mirdej/videobass/maxmsp/building/Building_Instructions.txt

Building instructions

1) Open ../Videobass.maxpat with MaxMSP
2) Make sure you switch to the main patch
2) Build standalone Application into building folder
3) Adapt version.txt
3) Run make in building folder

Move the resulting Videobass disk image to wherever you like
