mirdej/videobass/hardware/plans/Saddle.pdf

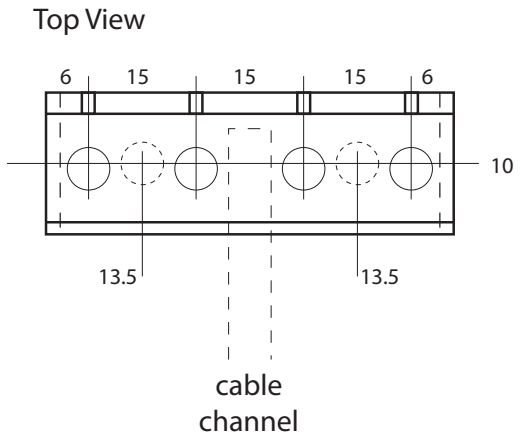
[picture p1: figure]
cable channel; Top View

5

Side View

8

## Videobass Saddle

Cut from hard wood
Michael Egger
2011-05-28
