mirdej/videobass/hardware/plans/Head.pdf

## Videobass Head

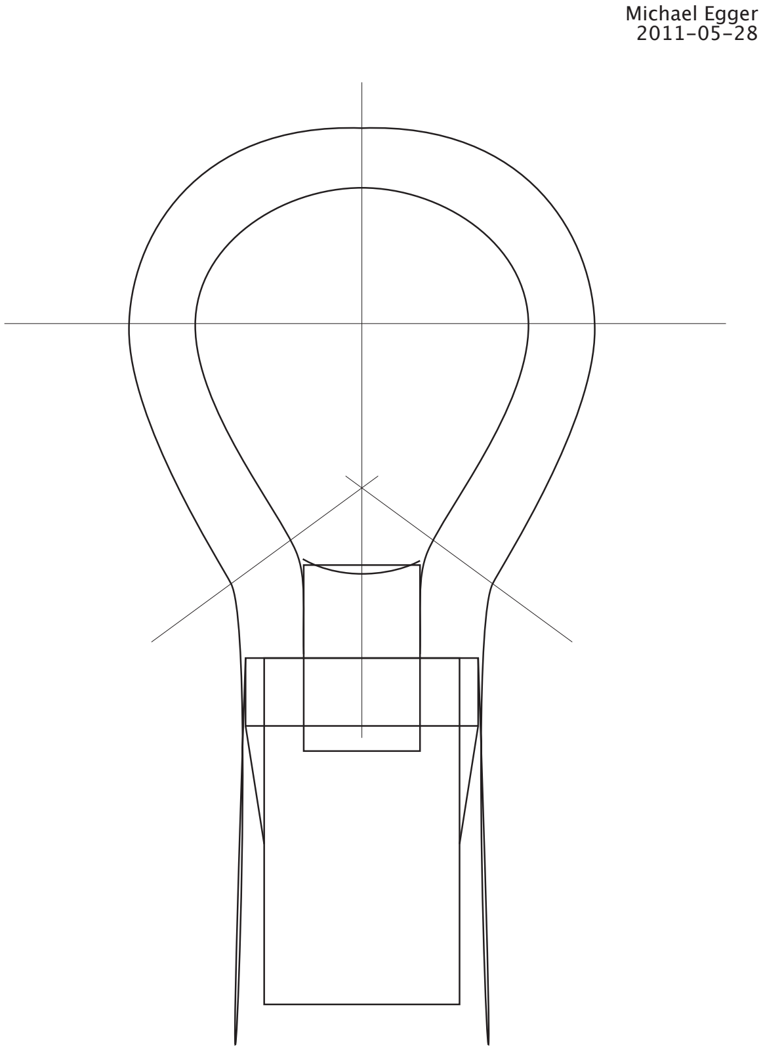
[picture p2: figure]
Michael Egger 2011-05-28
