mirdej/videobass/maxmsp/main/vb.viewer.pict.png

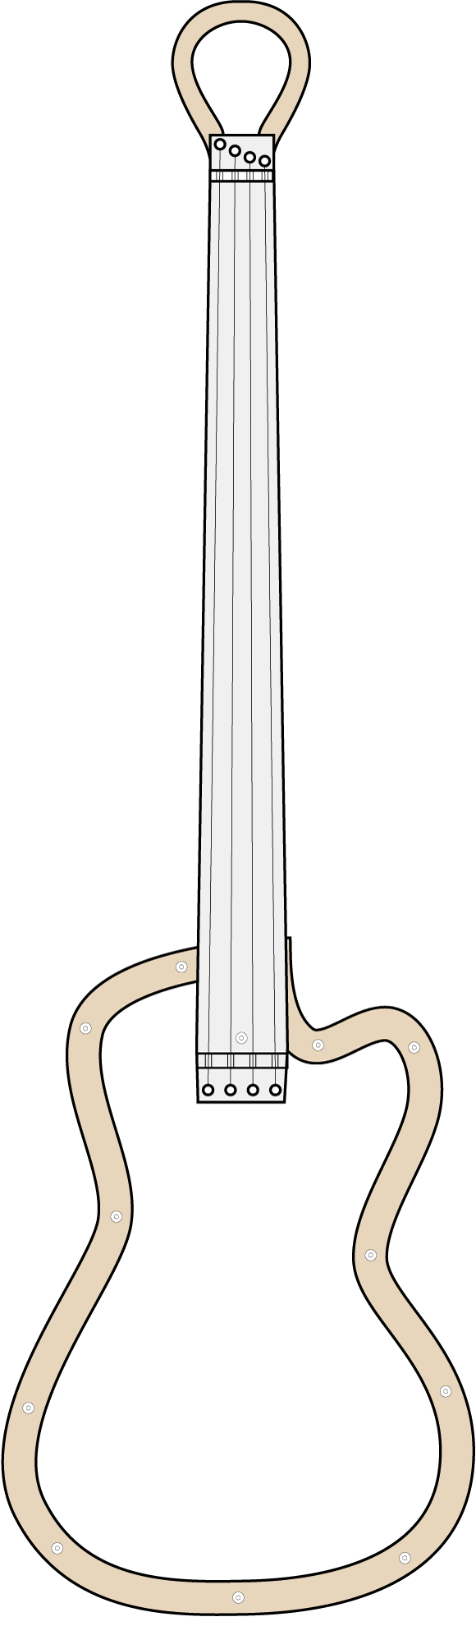
maxmsp/main/vb.viewer.pict.png
