mirdej/videobass/maxmsp/txt/hi.ExtendedUsages.txt

# extended usages - one symbol matches a usage page / usage pair.
#
# File format:
# <symbol> <usage-page> <usage>
# anything after a '#' will be ignored

mouse		1	0x02
gamepad		1	0x05
keyboard	1	0x06
xaxis		1	0x30
yaxis		1	0x31
slider		1	0x36
dial		1	0x37
wheel		1	0x38
