mirdej/videobass/maxmsp/txt/hi.UsagePages.txt

# extended usages - one symbol matches a usage page.
#
# File format:
# <symbol> <usage-page>
# anything after a '#' will be ignored

gendesk		 1
simcontrol	 2
vrcontrol	 3
sport		 4
game		 5
generic		 6
keyboard	 7
leds		 8
buttons		 9
ordinal		10
telephone	11
consumer	12
digitizers	13
unicode		16
alphanum	20
medical		64
