mirdej/videobass/maxmsp/building/ReadMe.rtf

Videobass 3.3.8.1 ReadMe

The Videobass is a unique hardware software combination -
an instrument that plays moving images instead of sound.

It is an open source project by Swiss media artist Michael Egger.
For more Information visit http://www.anyma.ch/research/videobass.

This is the Readme for the Videobass-Application.
In itself the Application is useless without the Videobass hardware controller (and, less so, the videobass "amplifier" hardware). Plans for building the necessary hardware can be found on the above website, on the SVN repository at http://code.google.com/p/videobass/ or by contacting the author by email: me-AT-anyma.ch

The application is written in MaxMSP/jitter - its source code is published under GNU GPL 3.0 or greater, please refer to the above SVN repository for latest sources.

Installation

Drag the Videobass Application into the Applications folder.
It will generate all necessary settings and folders on startup. These are:

~/Library/Preferences/Videobass/ for settings and preferences
~/Videobass Clips/ clips to be played by the videobass
~/Videobass Recordings/ recordings made by the videobass
~/Videobass Scales/ text files defining sets of clips

Changes in version 3.3.8.1
- fixed bug when changing scales would not remove clips from last scale

Changes in version 3.3.8
- added "scrubbing" or "tapping" mode. double-click the fold button to enter scrubbing mode

Changes in version 3.3.7
- added possibility to change the range of the speed control in the settings

Changes in version 3.3.6.1
- fixed build (3.3.6 does not work at all)

Changes in version 3.3.6
- reenabled luma key on the E string

Changes in version 3.3.5
- more reliable string calibration
- there's a beep when string in/out points are set

Changes in version 3.3.4
- buffer pedal only calibrates itself when we're actually calibrating
- disabled luma key on the E string to prevent accidental blackouts

Changes in version 3.3.3
- fixed a bug where live recording would reset the videobass
- fixed: recording names now properly display seconds
- disabled scale-change footpedal when no or just one scale present

Changes in version 3.3.2
- fixed fullscreen mode, leaving fullscreen will make a small window
- fixed 'unbound hi.in' error in vb.input
- cleaned up settings display
- fixed possible bug with NTSC recording
- strip path off clipnames when loading clips

Changes in version 3.3.1
- Interface adapts to any screen size: this version works also on a laptop
- Fixed bug where buffer detoriates over time
- Playback frame size can now be set in the settings panel

Changes in version 3.2.1

- added possibility to prepare scales: text files that define what clips are in which order on a string.
one can change from scale to scale quickly with the foot pedal

- fixed bug where unfolded clips would remain when reloading media.
- fixed string initialisation when changing scales

Changes in version 3.1.1

- textures sent over network are again in uyvy format for compatibilty with VideobassSyphonServer
- added settings for recording fps and size

Changes in version 3.1.0

- individual channels can now have luma key transparency. This changes somewhat the mixing behavior. For a description, see http://code.google.com/p/videobass/wiki/Mixing
- channel displays update more frequently

Bugfixes:
- fixed copying joystick settings from 4 to 1 and from 1 to 4
- movie transport mechanism now uses internal quicktime clock, this should render playback speed more reliable
- fixed bug where thumbnail of first clip would not show
- fixed bug where a recording slot was added even when no slots are requested
- live recording should now record at correct framerate
- clearing recordings works now even when there are spaces in hard disk name

Known Issues

- Playback is not optimized yet: frame rate is below optimal (usually between 16 and 20 fps)
- Playback is only extensively tested for clips in DV-PAL format (720x576 25fps 4:3)
- Playback is 4:3 only
