mirdej/videobass/syphon_server/building/Building_Instructions.txt

Building instructions

1) Open ../VideobassSyphonServer.maxpat with MaxMSP
2) Build standalone Application into building folder
3) Adapt version number in Makefile !!!
3) Run make in building folder

Move the resulting Videobass disk image to wherever youlike
