mirdej/videobass/maxmsp/building/vb.install.png

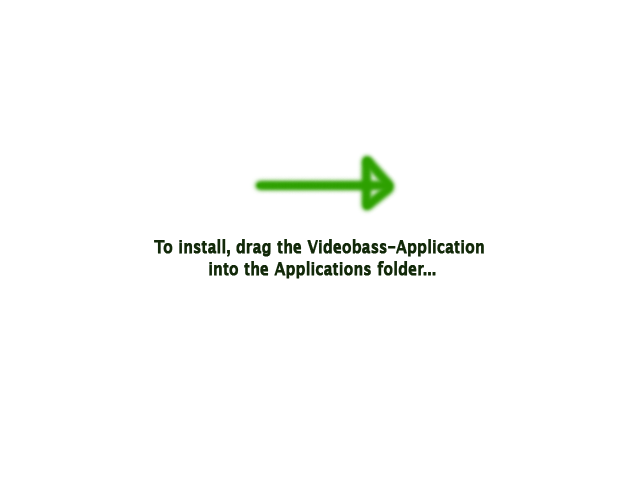
maxmsp/building/vb.install.png
