mirdej/videobass/hardware/electronics/pots_pcb.pdf

## Videobass Pot Board

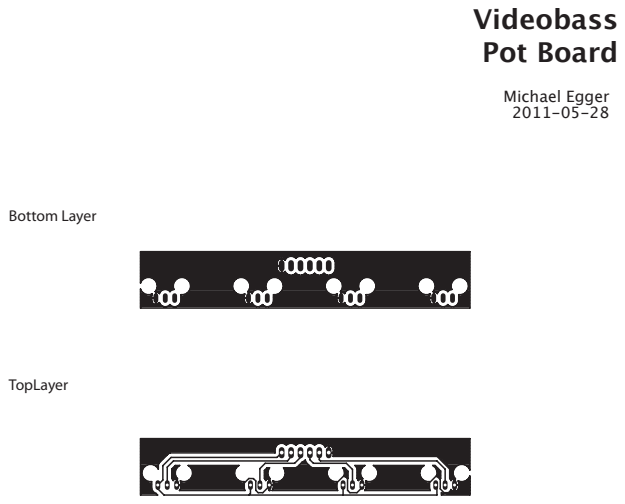
[picture p5: page 1]
Bottom Layer; TopLayer; Michael Egger 2011-05-28
