mirdej/videobass/hardware/electronics/amp-pcb.pdf

## Videobass Amplifier Board

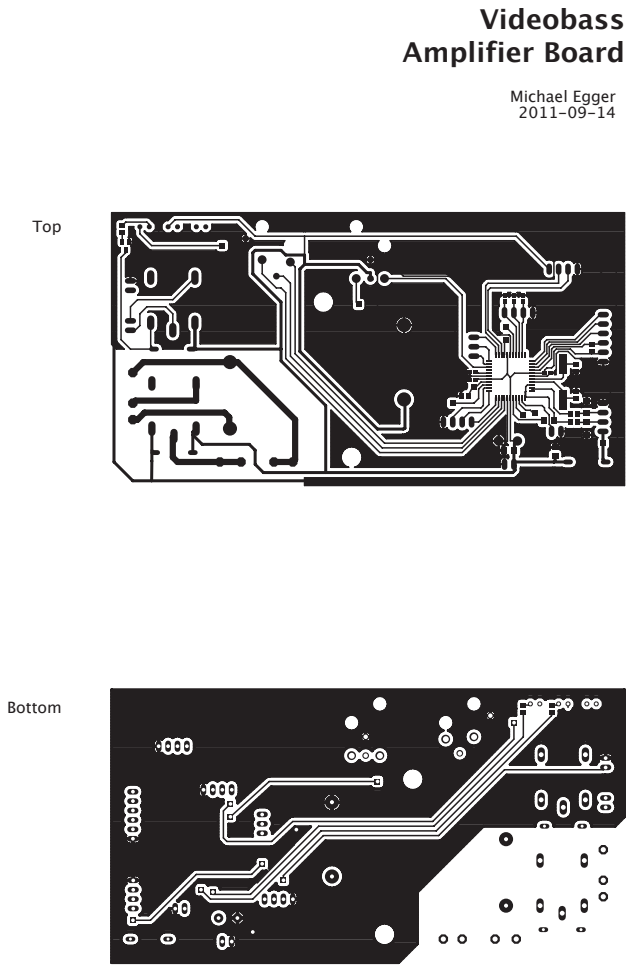
[picture p6: page 1]
Michael Egger 2011-09-14; Top; Bottom
