mirdej/videobass/hardware/electronics/cpu_pcb.pdf

## Bottom Layer

# Videobass

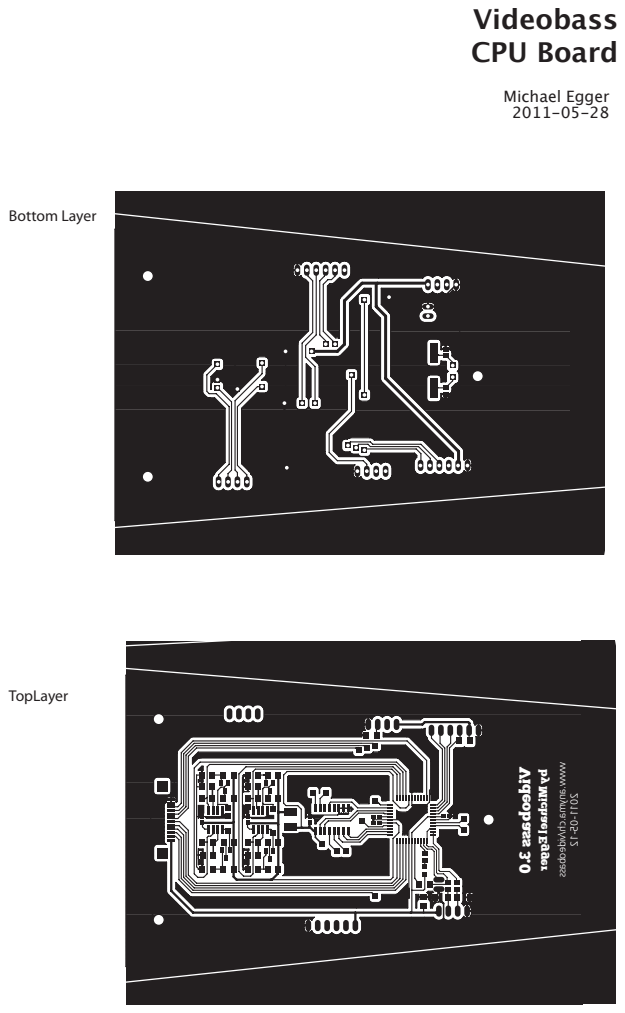
[picture p7: page 1]
Videobass 3.0; TopLayer; CPU Board; Michael Egger 2011-05-28

by Michael Egger

www.anyma.ch/videobass
