mirdej/videobass/hardware/electronics/joystick-pcb.pdf

## Videobass Joystick Board

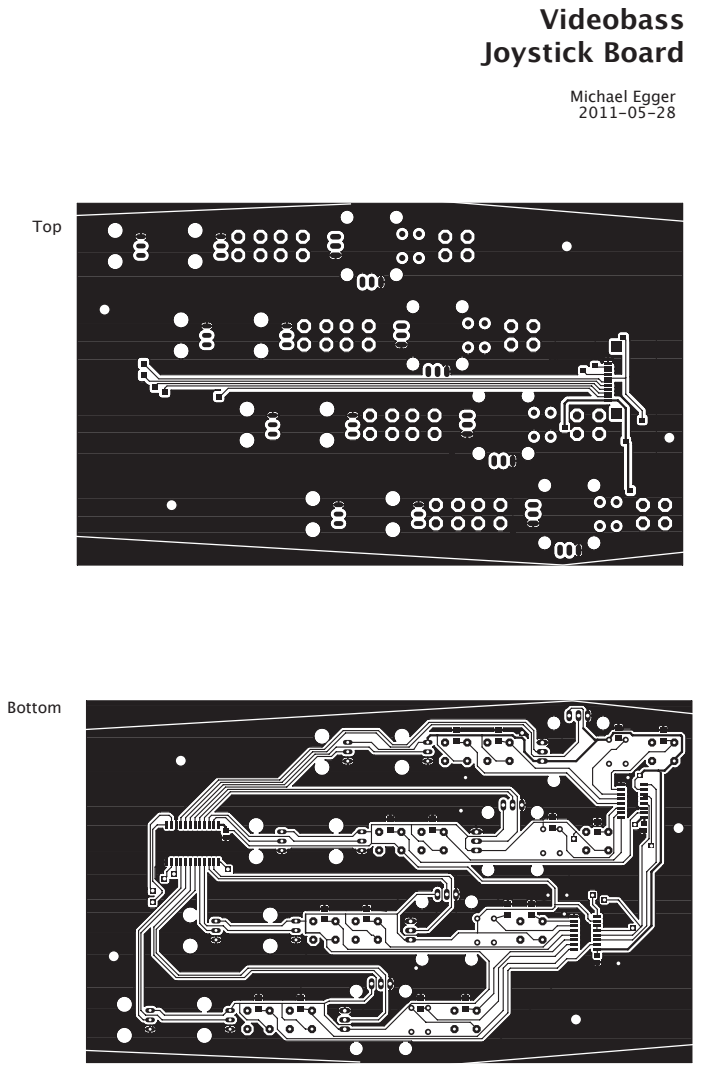
[picture p8: page 1]
Michael Egger 2011-05-28; Top; Bottom
