mirdej/videobass/hardware/plans/Body-Jig.pdf

## Videobass Body Jig

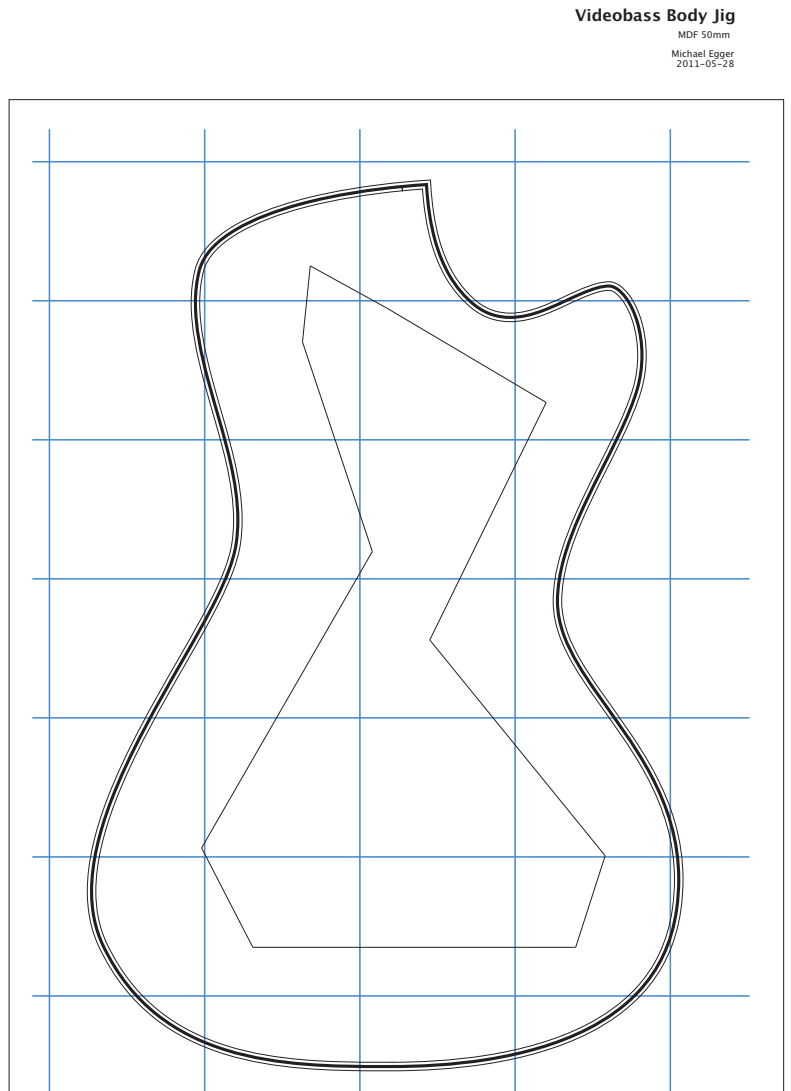
[picture p9: page 1]
MDF 50mm Michael Egger 2011-05-28
