mirdej/videobass/hardware/plans/Plexi_Drill_Template.pdf

# Videobass Plexi Drill Template

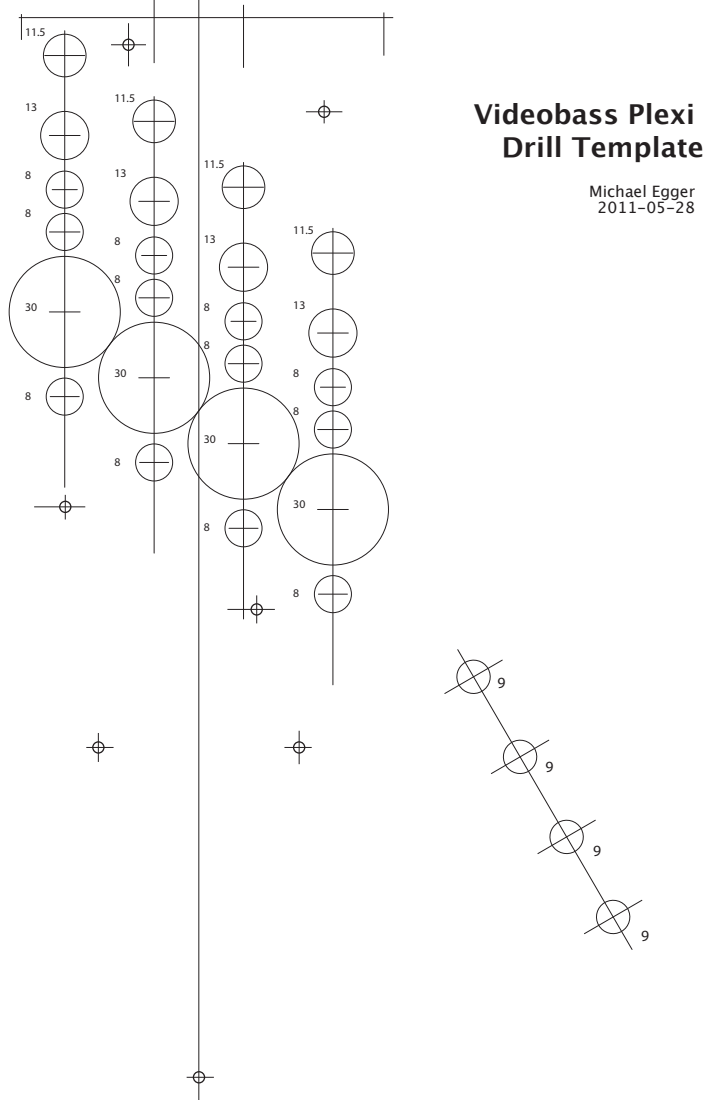
[picture p10: page 1]
Michael Egger 2011-05-28
