mirdej/videobass/hardware/plans/Stand.pdf

## Videobass Stand Cutting Template

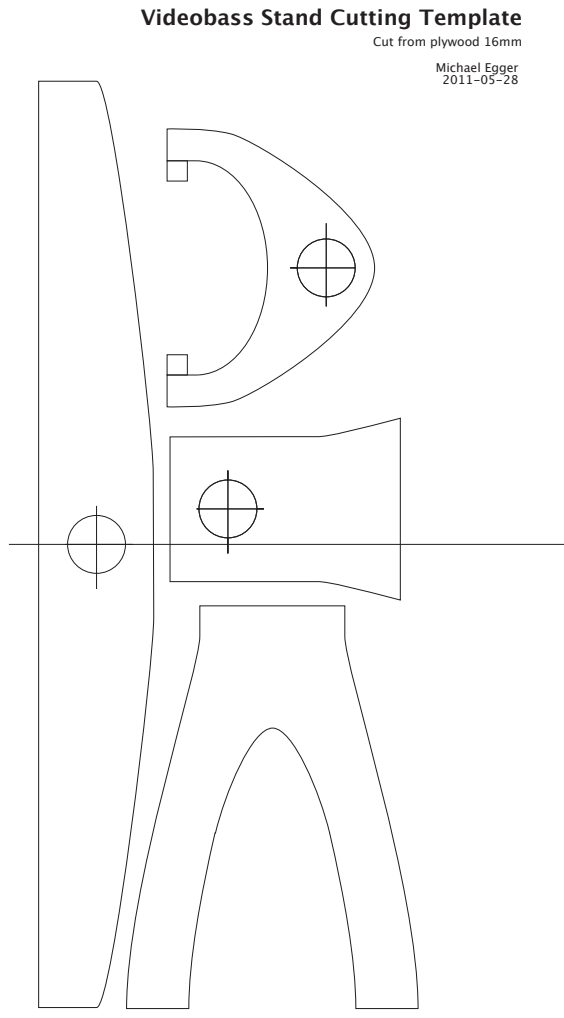
[picture p11: page 1]

Cut from plywood 16mm
Michael Egger
