mirdej/videobass/hardware/plans/Videobass.pdf

## Videobass Version 3.0

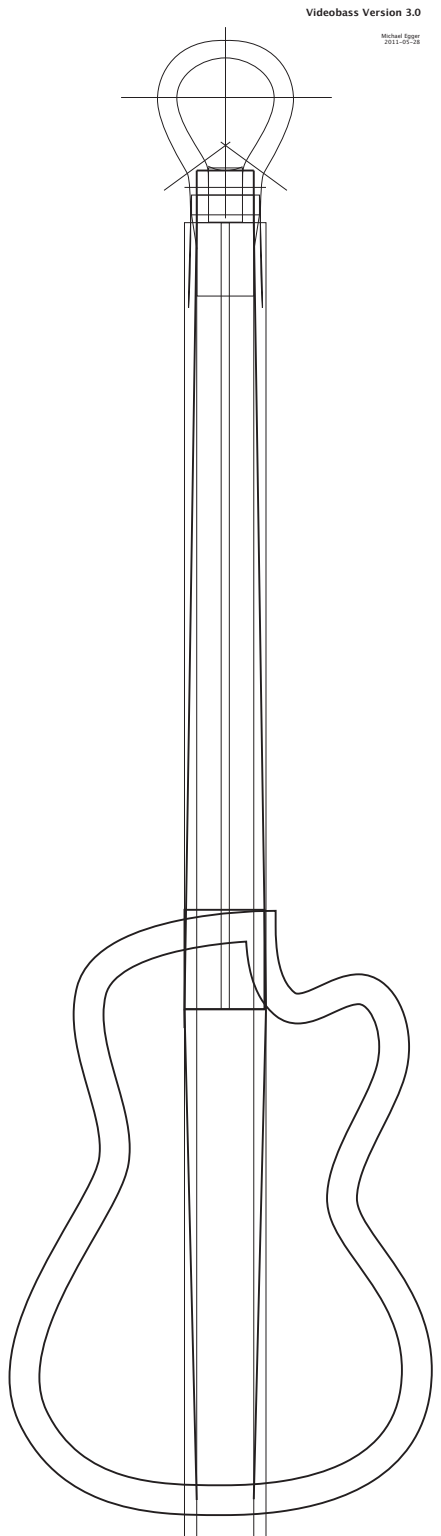
[picture p12: page 1]
Michael Egger 2011-05-28
