mirdej/videobass/hardware/electronics/cpu.brd

## EAGLE design hardware/electronics/cpu.brd (2012-11-18)

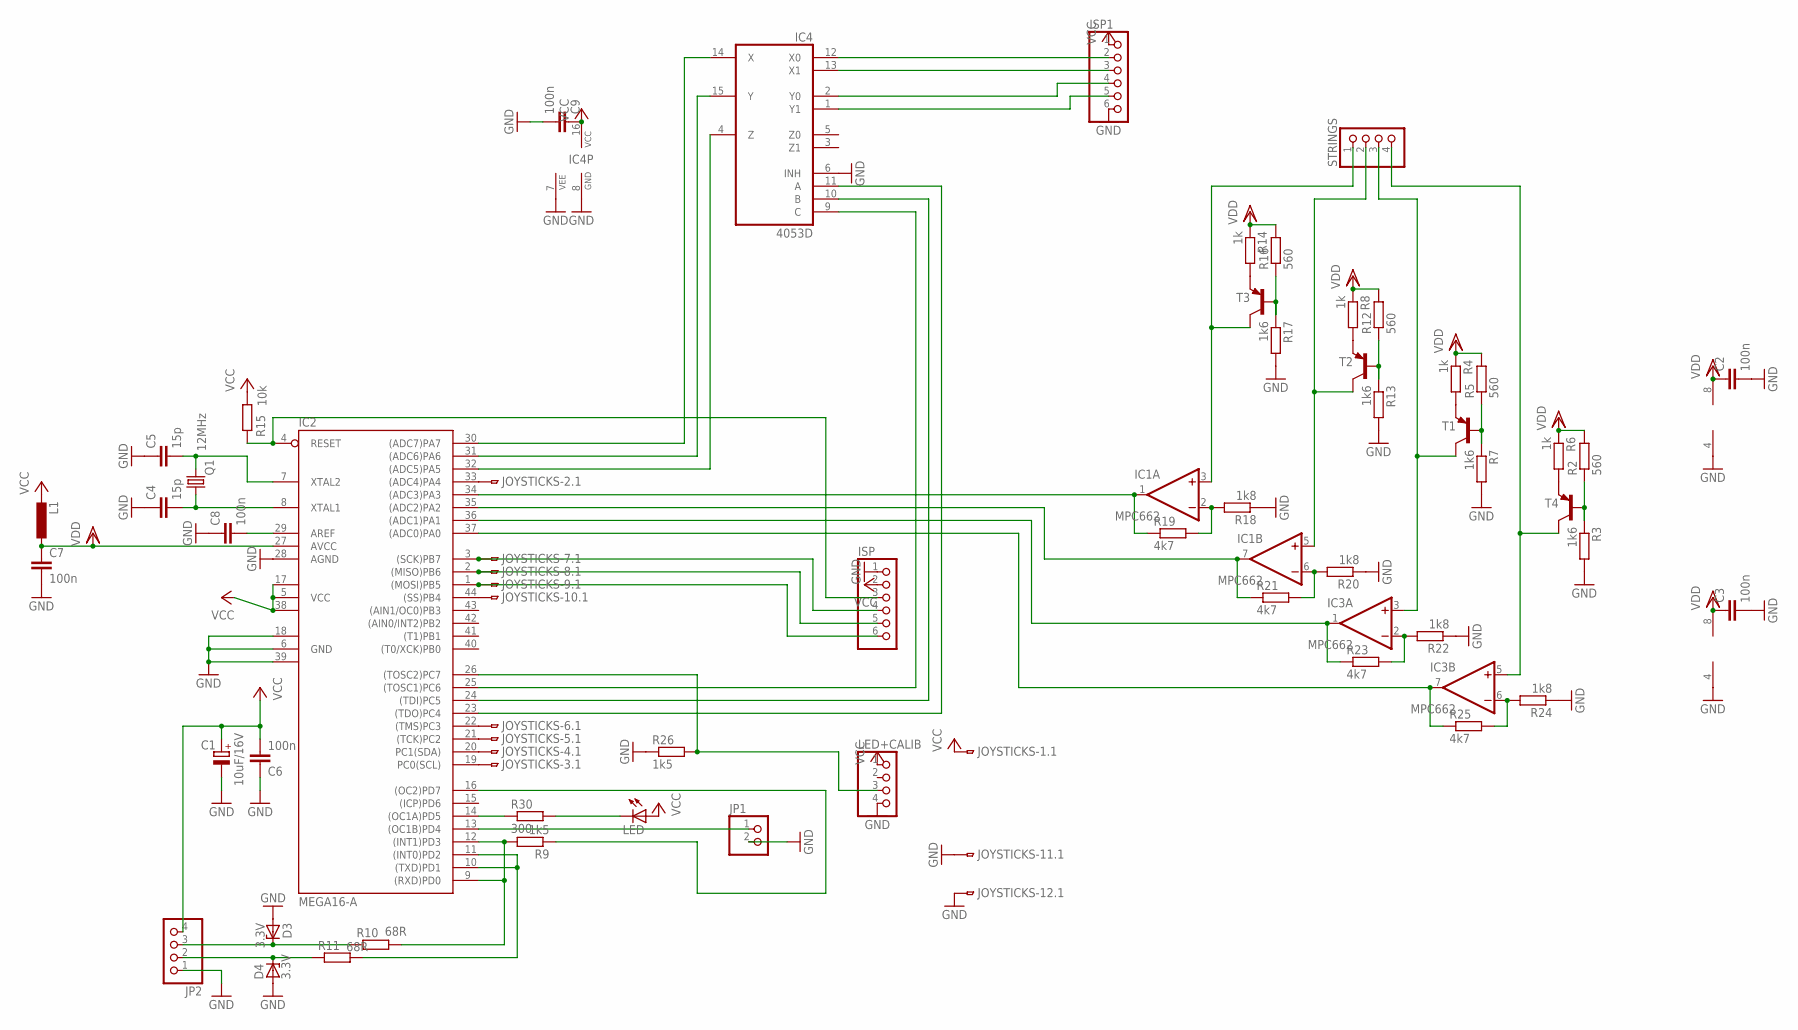
[picture p13: schematic cpu.sch]

Parts:
C1: 10uF/16V; R/2012-12R
C2, C3, C6, C7, C8, C9: 100n; C0603
C4, C5: 15p; C0805
D3, D4: 3.3V; SOD80C
IC1, IC3: MPC662; SO08
IC2: MEGA16-A; TQFP44
IC4: 4053D; SO16
ISP, ISP1: PINHD-1X6; 1X06
JOYSTICKS: MOLEX-52207-1285; 52207-1285
JP1: PINHD-1X2; 1X02
JP2: PINHD-1X4; 1X04
L1: L-EUL1812; L1812
LED: LEDCHIPLED_0805; CHIPLED_0805
LED+CALIB: PINHD-1X4; 1X04
Q1: 12MHz; HC49UP
R2, R5, R12, R16: 560; R1206
R3, R7, R13, R17: 1k6; R1206
R4, R6, R8, R14: 1k; R1206
R9, R26: 1k5; R1206
R10, R11: 68R; M0805
R15: 10k; R1206
R18, R20, R22, R24: 1k8; R1206
R19, R21, R23, R25: 4k7; R1206
R30: 300; M0805
STRINGS: PINHD-1X4; 1X04
T1, T2, T3, T4: -PNP-SOT23-BCE; SOT23-BCE

Connections:
D+: D4.C, JP2.2, R11.1
D-: D3.C, JP2.3, R10.1
GND: C1.-, C2.2, C3.2, C4.1, C5.1, C6.1, C7.2, C8.1, C9.2, D3.A, D4.A, IC1.4 (V-), IC2.6 (GND), IC2.18 (GND1), IC2.28 (AGND), IC2.39 (GND2), IC3.4 (V-), IC4.6 (INH), IC4.7 (VEE), IC4.8 (GND), ISP.1, ISP1.6, JOYSTICKS.P$11, JOYSTICKS.P$12, JP1.2, JP2.1, LED+CALIB.4, R3.2, R7.2, R13.2, R17.2, R18.1, R20.1, R22.1, R24.1, R26.1
unnamed: IC2.9 ((RXD)PD0), IC2.12 ((INT1)PD3), R9.2, R10.2
unnamed: IC1.1 (OUT), IC2.34 ((ADC3)PA3), R19.1
unnamed: IC1.2 (-IN), R18.2, R19.2
unnamed: IC2.1 ((MOSI)PB5), ISP.6, JOYSTICKS.P$9
unnamed: IC1.6 (-IN), R20.2, R21.2
unnamed: C4.2, IC2.8 (XTAL1), Q1.1
unnamed: IC4.13 (X1), ISP1.3
unnamed: IC2.14 ((OC1A)PD5), R30.1
unnamed: IC4.12 (X0), ISP1.2
unnamed: IC2.13 ((OC1B)PD4), JP1.1
unnamed: C8.2, IC2.29 (AREF)
unnamed: R6.2, T4.E
unnamed: IC2.16 ((OC2)PD7), R9.1
unnamed: LED.C, R30.2
unnamed: IC3.5 (+IN), STRINGS.4, T4.C
unnamed: R2.1, R3.1, T4.B
unnamed: R4.2, T1.E
unnamed: IC3.3 (+IN), STRINGS.3, T1.C
unnamed: R5.1, R7.1, T1.B
unnamed: R8.2, T2.E
unnamed: IC1.5 (+IN), STRINGS.2, T2.C
unnamed: R12.1, R13.1, T2.B
unnamed: R14.2, T3.E
unnamed: IC1.3 (+IN), STRINGS.1, T3.C
unnamed: R16.1, R17.1, T3.B
unnamed: IC1.7 (OUT), IC2.35 ((ADC2)PA2), R21.1
unnamed: IC2.10 ((TXD)PD1), IC2.11 ((INT0)PD2), R11.2
unnamed: IC3.2 (-IN), R22.2, R23.2
unnamed: IC2.36 ((ADC1)PA1), IC3.1 (OUT), R23.1
unnamed: IC3.6 (-IN), R24.2, R25.2
unnamed: IC2.37 ((ADC0)PA0), IC3.7 (OUT), R25.1
unnamed: IC2.2 ((MISO)PB6), ISP.5, JOYSTICKS.P$8
unnamed: IC2.3 ((SCK)PB7), ISP.4, JOYSTICKS.P$7
unnamed: IC2.33 ((ADC4)PA4), JOYSTICKS.P$2
unnamed: IC2.19 (PC0(SCL)), JOYSTICKS.P$3
unnamed: IC2.20 (PC1(SDA)), JOYSTICKS.P$4
unnamed: IC2.21 ((TCK)PC2), JOYSTICKS.P$5
unnamed: C5.2, IC2.7 (XTAL2), Q1.2
unnamed: IC2.22 ((TMS)PC3), JOYSTICKS.P$6
unnamed: IC2.44 ((SS)PB4), JOYSTICKS.P$10
unnamed: IC2.32 ((ADC5)PA5), IC4.4 (Z)
unnamed: IC2.31 ((ADC6)PA6), IC4.15 (Y)
unnamed: IC2.30 ((ADC7)PA7), IC4.14 (X)
unnamed: IC2.23 ((TDO)PC4), IC4.11 (A)
unnamed: IC2.24 ((TDI)PC5), IC4.10 (B)
unnamed: IC2.25 ((TOSC1)PC6), IC4.9 (C)
unnamed: IC4.2 (Y0), ISP1.4
unnamed: IC4.1 (Y1), ISP1.5
unnamed: IC2.26 ((TOSC2)PC7), LED+CALIB.3, R26.2
unnamed: IC2.4 (RESET), ISP.3, R15.1
VCC: C1.+, C6.2, C9.1, IC2.5 (VCC), IC2.17 (VCC1), IC2.38 (VCC2), IC4.16 (VCC), ISP.2, ISP1.1, JOYSTICKS.P$1, JP2.4, L1.2, LED.A, LED+CALIB.1, R15.2
VDD: C2.1, C3.1, C7.1, IC1.8 (V+), IC2.27 (AVCC), IC3.8 (V+), L1.1, R2.2, R4.1, R5.2, R6.1, R8.1, R12.2, R14.1, R16.2

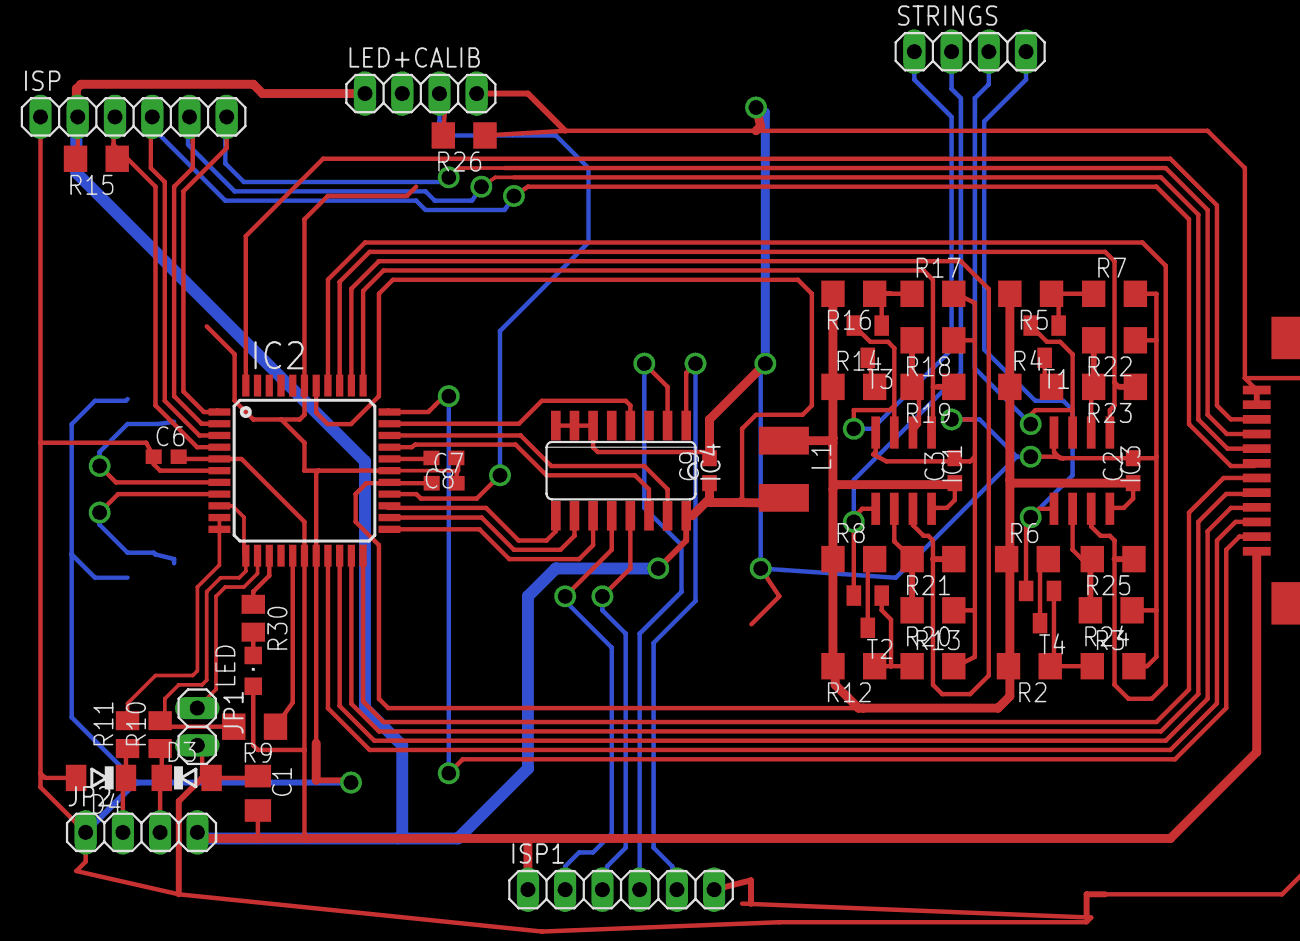
[picture p14: board cpu.brd from above]

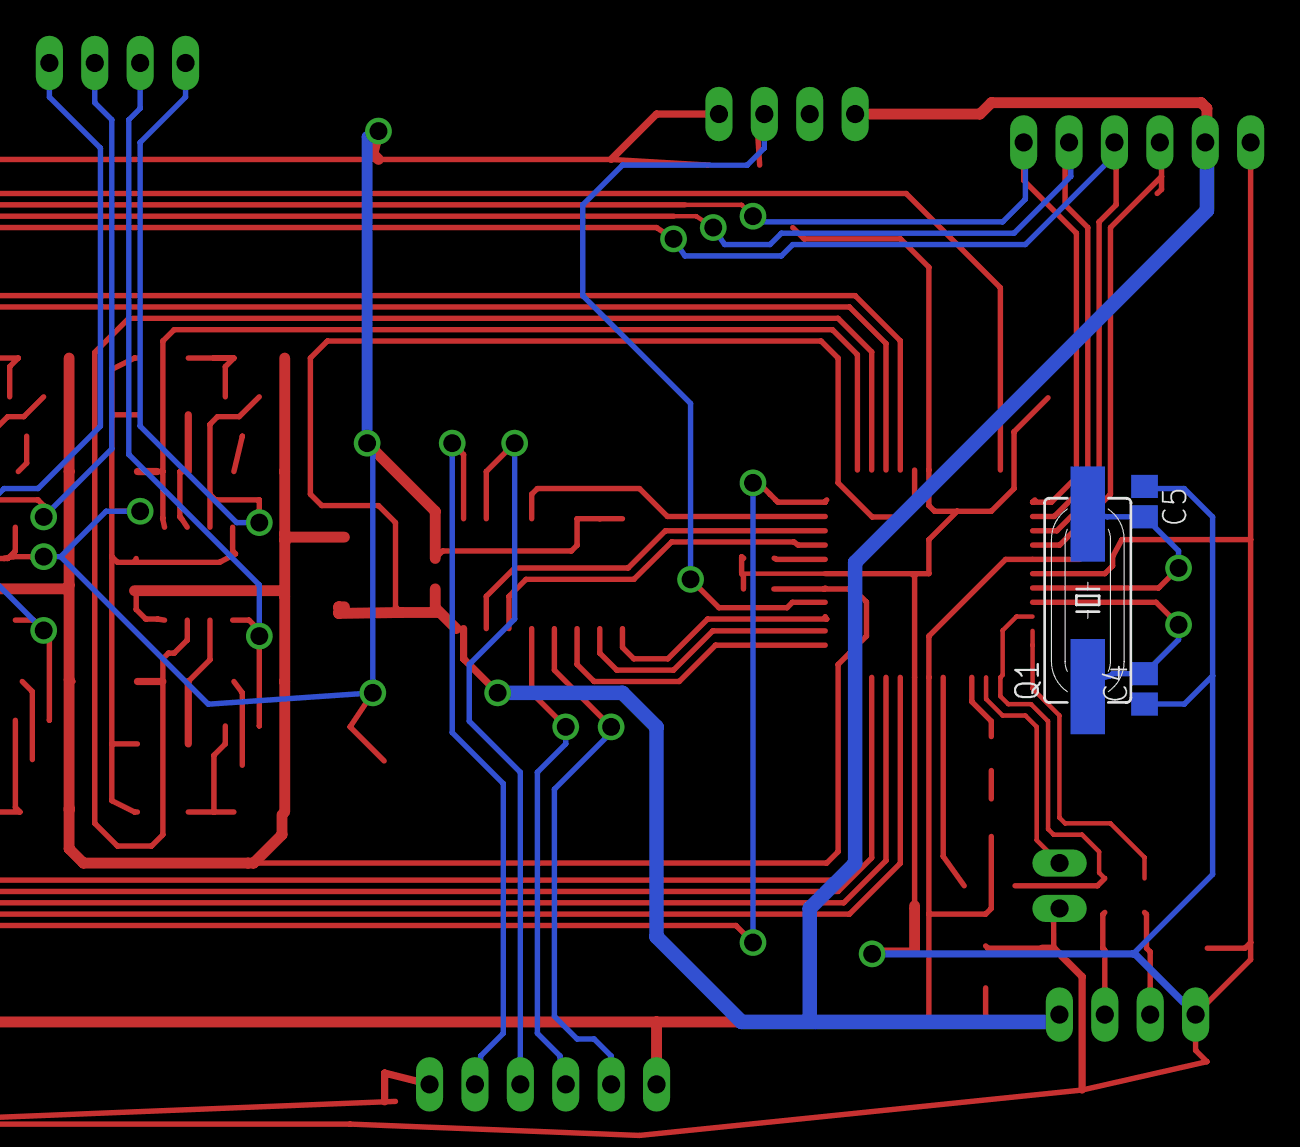
[picture p15: board cpu.brd from below]

Board: 2 copper layers, 55 parts (3 on the bottom side), 55 nets.
