mirdej/videobass/(commit log)

2010-01-19 sorry, I just deleted the trunk, here are the files back. still trying to getting used to svn
    [buttons.brd, buttons.sch, cpu.brd, cpu.sch, joysticks.brd, joysticks.sch, pasApasButtons.brd, pasApasButtons.sch]
2010-01-23 automatic power up
2010-06-22 commented out power_up routine, because we're still playing with the old gnusb renamed as vamp, without automatic power detection
2011-04-16 added rotary button
2011-05-06 changed manufacturer to anyma.ch/vamp because of a bug in current hi.tools that prevents correct product matching when multiple devices by same manufacturer are present
    [main.c, usbconfig.h]
2011-05-08 reversed x and y on joysticks
    [main.c]
2011-05-08 enabled PWM on PB3 for led control
2011-05-11 Removed PWM for Led illumination. It causes too much noise on the analog side of things....
    [main.c, reportDescriptor.c]
2011-05-11 added calibration button
2011-05-11 added joystick buttons
2011-05-16 changed back to correct manufacturer www.anyma.ch - hi.tools have been updated and product matching works again---
    [usbconfig.h]
2011-05-17 adapted vamp firmware to latest version of hardware. new power up sequence: vamp shorts mac mini power button for 2 secs, pauses 1 sec, and again until it sees power on the usb bus. spare pin on peda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
    [main.c]
2011-05-21 changed rotary wheel routine to trigger only half of the time
2011-05-21 added power deamon. unfinished transition away from the database for persistent settings. vb.setting writes ts contents to a plain text file in ~/Library/Preferences/Videobass. vb.zone.ui is now a re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
2011-05-26 Renamed and integrated vb.viewer. Integrated vb.joxstick.setup. Added fullscreen option. Fixed bug in centerdetent that would output -1. on load. Added settings for cut threshold and fade speed
2011-05-28 Updated circuit schematics, added building plans
    [amp.brd, amp.sch, buttons.brd, buttons.sch, cpu.brd, cpu.sch, joysticks.brd, joysticks.sch]
2011-06-09 some small improvements but lumakey still not working properly. will crate a branch for this one to come back later. current development has to focus on the version of tag bilbo2011
2011-06-11 First version of Videobass Syphon Server. Some issues building it because of some strange MaxMSP framework bug
2011-09-14 v+ trace on amp pcb was too near to the edge of the board. corrected
    [amp.brd, amp.sch]
2011-12-01 integrated joystick centering into vb.joystick. removed unused vb.networkinfo. moved hi.dev vamp from vb.viewer into main engine. settings button now opens a small settings window - removed vb.viewer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
2012-01-18 updated readme, version number for 3.3.3 build. including cg-framework
2012-05-16 buffer level calibration takes place only while calibrating strings
2012-05-16 removed old version of vb.string.calibrate
2012-05-16 more reliable string lo-thresh calibration
2012-05-16 updated source code of string.calibrate
2012-11-17 added missing potentiometer board
2012-11-18 corrected resitor values for string ingputs
    [cpu.brd, cpu.sch]
2012-11-18 corrected opamp for string-input circuit. lm833 does not work in these cirustances here. have to use mpc662
    [cpu.brd, cpu.sch]
